Radionews/diduino/README.md

# Программатор дидuino

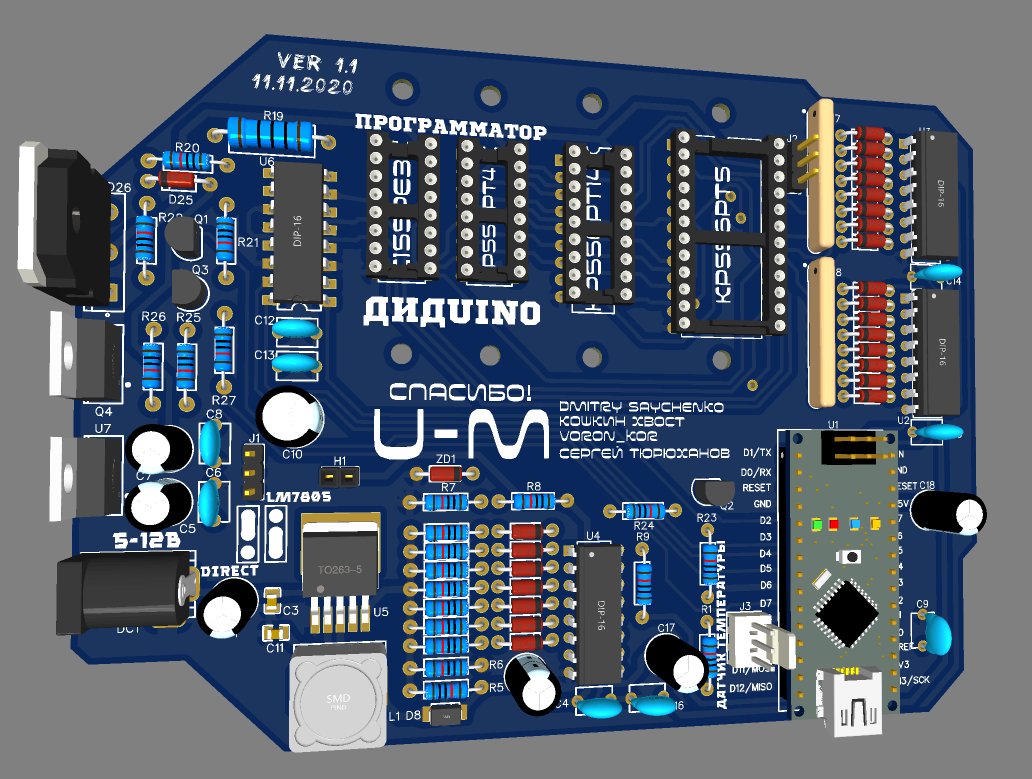
[picture p1: img/board.png]
Плата Дидuino Дидuino


Проект программатора микросхем ППЗУ: К155РЕ3, КР556РТ4, КР556РТ14, КР556РТ5 и их аналогов. Основан на основе следующих проектов:
* [Проект программатора ProgRT](https://zx-pk.ru/threads/15617-programmator-ppzu-155re3-556rt4-i-drugikh.html "Ссыдка на форум ZX-PK")
* [Проект программатора от walhi](https://github.com/walhi/arduino_eprom27_programmer "Ссыдка на github")

Принципиальная схема:

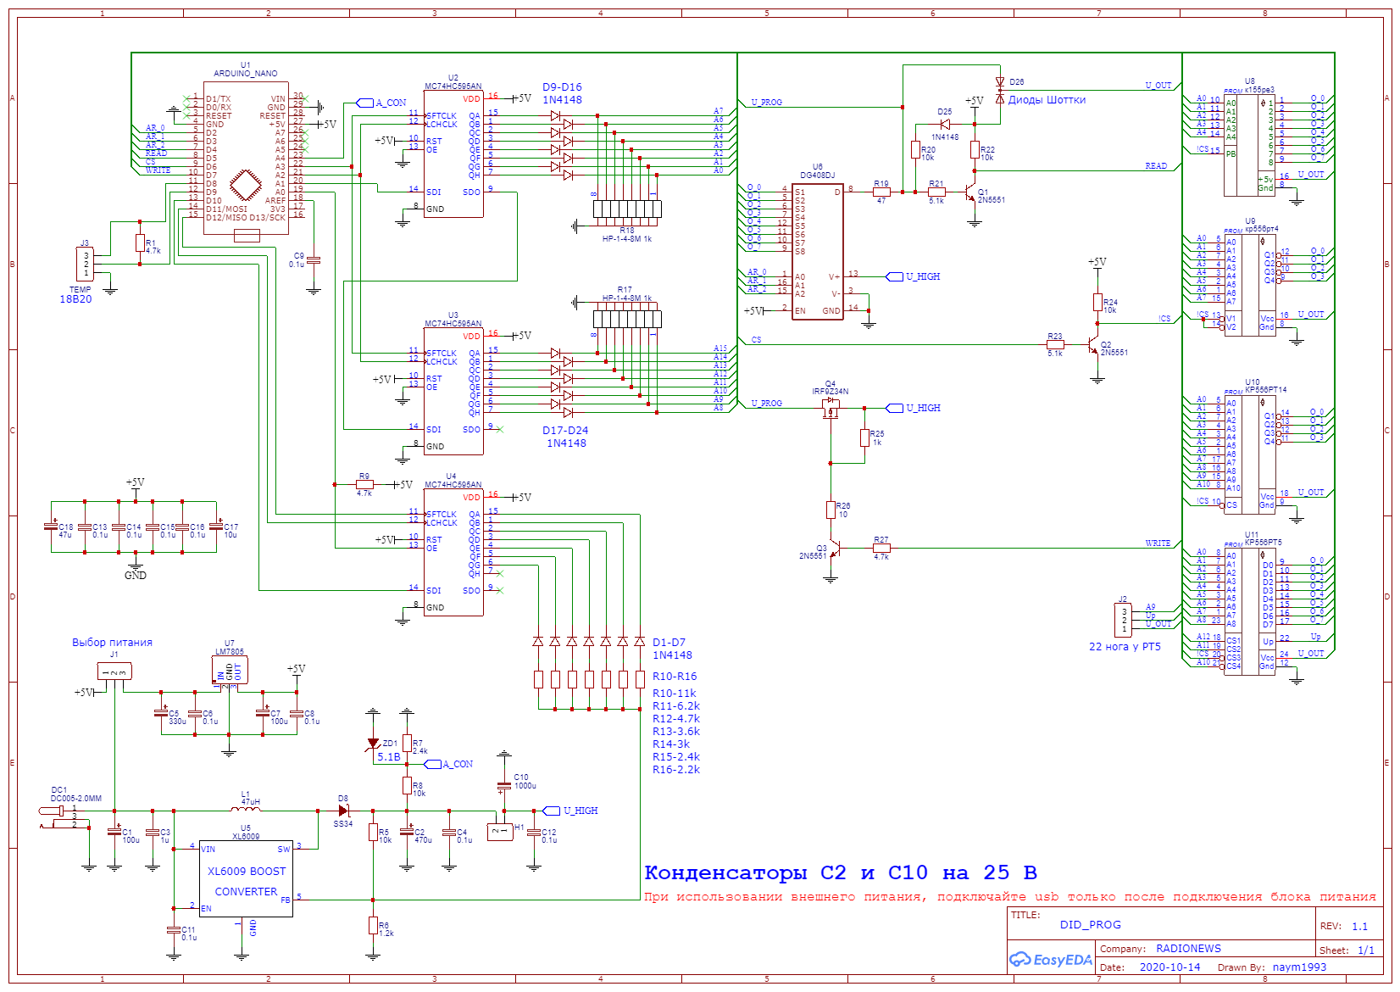
[picture p2: img/scheme.png]
Принципиальная схема


Проект схемы и платы: <https://easyeda.com/naym1993/prog_did>

Принцип работы регулятора на XL60009 рассматривался [в этом видео](https://youtu.be/bcgiW_VbnP0 "Ссыдка на youtube")

**В версии печатной платы 1.0 совершена ошибка в разводке платы!!** 

Необходимо поменять сток исток в силовом транзисторе.

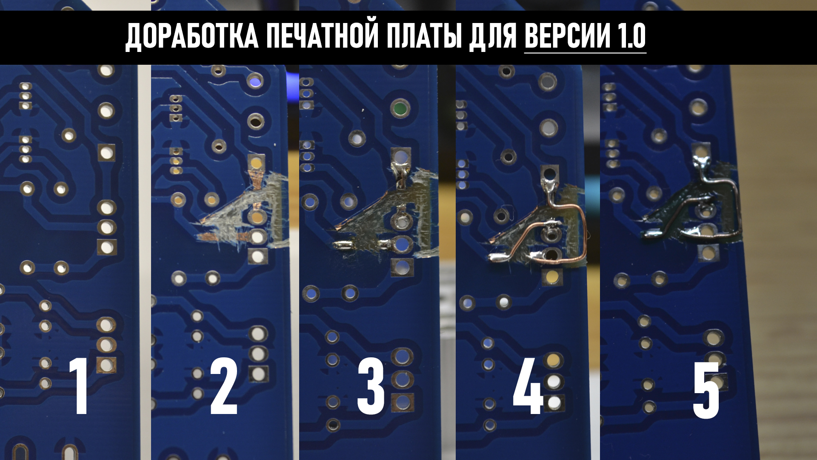
[picture p3: img/fix_for_1.0.jpg]
Доработка платы версии 1.0 Доработка


Подробней рассматриваю этот вопрос в видео: <https://youtu.be/s_gQgh_qvWw>

**В версии печатной платы 1.1 так же найден недочет!!! Спасибо PticDado!** 

Резисторная сборка R18 не подключена к земле. Контакт просто в воздухе висит, надо кинуть перемычку до земли (она вокруг контакта).
В проекте easyEDA печатная плата уже поправлена. 

## Дидuino programmer

Project of the programmer of ROM chips: K155RE3, KR556RT4, KR556RT14, KR556RT5 and their analogs. It is based on the following projects:
* [ProgRT programmer project](https://zx-pk.ru/threads/15617-programmator-ppzu-155re3-556rt4-i-drugikh.html "Link to ZX-PK forum")
* [Programmer project by walhi](https://github.com/walhi/arduino_eprom27_programmer "Link to github")

Circuit and board design: <https://easyeda.com/naym1993/prog_did>

The principle of the XL60009 regulator was discussed [in this video](https://youtu.be/bcgiW_VbnP0 "Youtube link")
