Radionews/diduino/(threads)

Thread 1 (2022-09-04):

Сеть SIL резисторов R18 не подключена к GND

PticDado, 2022-09-04:
Здравствуйте,

На печатной плате VER 1.1 есть ошибка. Сеть SIL резисторов R18 не подключена к GND, как это должно быть.
В остальном, поздравляю с проектом.

С уважением,

Radovan

Radionews, 2023-01-29:
Спасибо! Плату поправил, информацию об этом включил в репозиторий!

Closed 2023-01-29.
