Radionews/diduino/(commit log)

2021-02-01 Первый коммит. Функции чтения и записи работают.
2021-02-01 Добавлены изображения, скорректирован readme
2021-02-02 поправил описание
2021-02-03 добавил функционал индикатора подключенности программатора и вызов окна о программе
2021-02-13 добавлена поддержка рт5, добавлена информация о доработке печатной платы версии 1.0
2021-02-16 Поправлена функция записи. Реализована функция сравнения содержимого буферов. Исправлены различные баги.
    Нет функции проверки на возможность записи и параметры прожига пока не отправляются в дидуино.
    [diduino.ino]
2021-03-06 добавлена отправка настроек режима программирования (длительность импульсов и напряжение и т.п.)
2021-03-06 Поправлена принципиальная схема
2021-03-06 поправленные ico и ресурсы сборки
2021-03-23 Изменение название кнопки connect, дописал readme
2023-01-29 Update README.md
    Добавил информацию по R18 в версии 1.1
